hridaykrishna2007-a11y/rp-Board/Images/PCB F&B.png

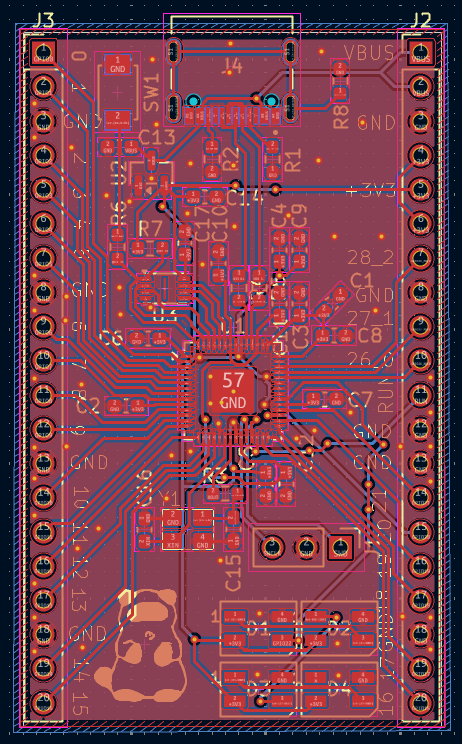
Images/PCB F&B.png
