hridaykrishna2007-a11y/rp-Board/BOM/BOM.csv

Index | LCSC# | MPN | Manufacturer | Package | Customer # | Description | RoHS | Quantity | MOQ | Multiple | Unit Price($) | Extended Price($) | Product Link
1 | C2040 | RP2040 | Raspberry Pi | LQFN-56(7x7) |  | ARM Cortex-M0+ 32 Bit 133MHz LQFN-56(7x7) Microcontrollers | yes | 4 | 1 | 1 | 0.9975 | 3.99 | https://www.lcsc.com/product-detail/C2040.html
2 | C29936 | CL10B105KA8NNNC | Samsung Electro-Mechanics | 0603 |  | 1uF ±10% 25V Ceramic Capacitor X7R 0603 | yes | 100 | 10 | 10 | 0.0179 | 1.79 | https://www.lcsc.com/product-detail/C29936.html
3 | C1591 | CL10B104KB8NNNC | Samsung Electro-Mechanics | 0603 |  | 100nF ±10% 50V Ceramic Capacitor X7R 0603 | yes | 100 | 100 | 100 | 0.0084 | 0.84 | https://www.lcsc.com/product-detail/C1591.html
4 | C1691 | CL10A106MQ8NNNC | Samsung Electro-Mechanics | 0603 |  | 10uF ±20% 6.3V Ceramic Capacitor X5R 0603 | yes | 100 | 10 | 10 | 0.0145 | 1.45 | https://www.lcsc.com/product-detail/C1691.html
5 | C2907044 | FRC0603F5101TS | FOJAN | 0603 |  | 5.1kΩ ±1% 100mW 0603 Thick Film Resistor | yes | 100 | 100 | 100 | 0.0019 | 0.19 | https://www.lcsc.com/product-detail/C2907044.html
6 | C2907002 | FRC0603F1001TS | FOJAN | 0603 |  | 1kΩ ±1% 100mW 0603 Thick Film Resistor | yes | 100 | 100 | 100 | 0.0021 | 0.21 | https://www.lcsc.com/product-detail/C2907002.html
7 | C2907136 | FRC0603J270 TS | FOJAN | 0603 |  | 27Ω ±5% 100mW 0603 Thick Film Resistor | yes | 100 | 100 | 100 | 0.0022 | 0.22 | https://www.lcsc.com/product-detail/C2907136.html
8 | C95204 | RT0603BRD0710KL | YAGEO | 0603 |  | 100mW 10kΩ 75V Thin Film Resistor ±25ppm/℃ ±0.1% 0603 Chip Resistor - Surface Mount RoHS | yes | 40 | 20 | 20 | 0.0331 | 1.32 | https://www.lcsc.com/product-detail/C95204.html
9 | C1663 | CL10C330JB8NNNC | Samsung Electro-Mechanics | 0603 |  | 33pF ±5% 50V Ceramic Capacitor C0G 0603 | yes | 100 | 50 | 50 | 0.0089 | 0.89 | https://www.lcsc.com/product-detail/C1663.html
10 | C39051 | MCP1700T-3302E/TT | MICROCHIP | SOT-23 |  | 3.3V Positive Fixed SOT-23 Voltage Regulators - Linear, Low Drop Out (LDO) Regulators RoHS | yes | 5 | 1 | 1 | 0.3999 | 2.00 | https://www.lcsc.com/product-detail/C39051.html
11 | C9002 | X322512MSB4SI | YXC Crystal Oscillators | SMD3225-4P |  | Crystal 12MHz ±10ppm 20pF SMD3225-4P | yes | 5 | 5 | 5 | 0.0960 | 0.48 | https://www.lcsc.com/product-detail/C9002.html
12 | C2765186 | TYPE-C 16PIN 2MD(073) | SHOU HAN | SMD |  | USB-C (USB TYPE-C) Receptacle Connector 16 Position Surface Mount, Right Angle | yes | 20 | 20 | 20 | 0.0716 | 1.43 | https://www.lcsc.com/product-detail/C2765186.html
13 | C720477 | TS-1088-AR02016 | XUNPU | SMD,4x3mm |  | Tactile Switch SPST 160gf 2mm SMD (SMT) Tab 4mm x 3mm Surface Mount | yes | 10 | 10 | 10 | 0.0504 | 0.50 | https://www.lcsc.com/product-detail/C720477.html
14 | C2456208 | W25Q16JVZPIQ | Winbond | WSON-8-EP(5x6) |  | 16Mbit 2.7V~3.6V 133MHz SPI WSON-8-EP(5x6) Memory RoHS | yes | 4 | 1 | 1 | 1.9161 | 7.66 | https://www.lcsc.com/product-detail/C2456208.html
15 | C114586 | WS2812B-B/W | Worldsemi | SMD5050-4P |  | SMD5050-4P LED Addressable, Specialty | yes | 10 | 5 | 5 | 0.1042 | 1.04 | https://www.lcsc.com/product-detail/C114586.html
