hridaykrishna2007-a11y/rp-Board/PCB/rp2040 led.kicad_pcb

## KiCad design PCB/rp2040 led.kicad_pcb (2026-10-29)

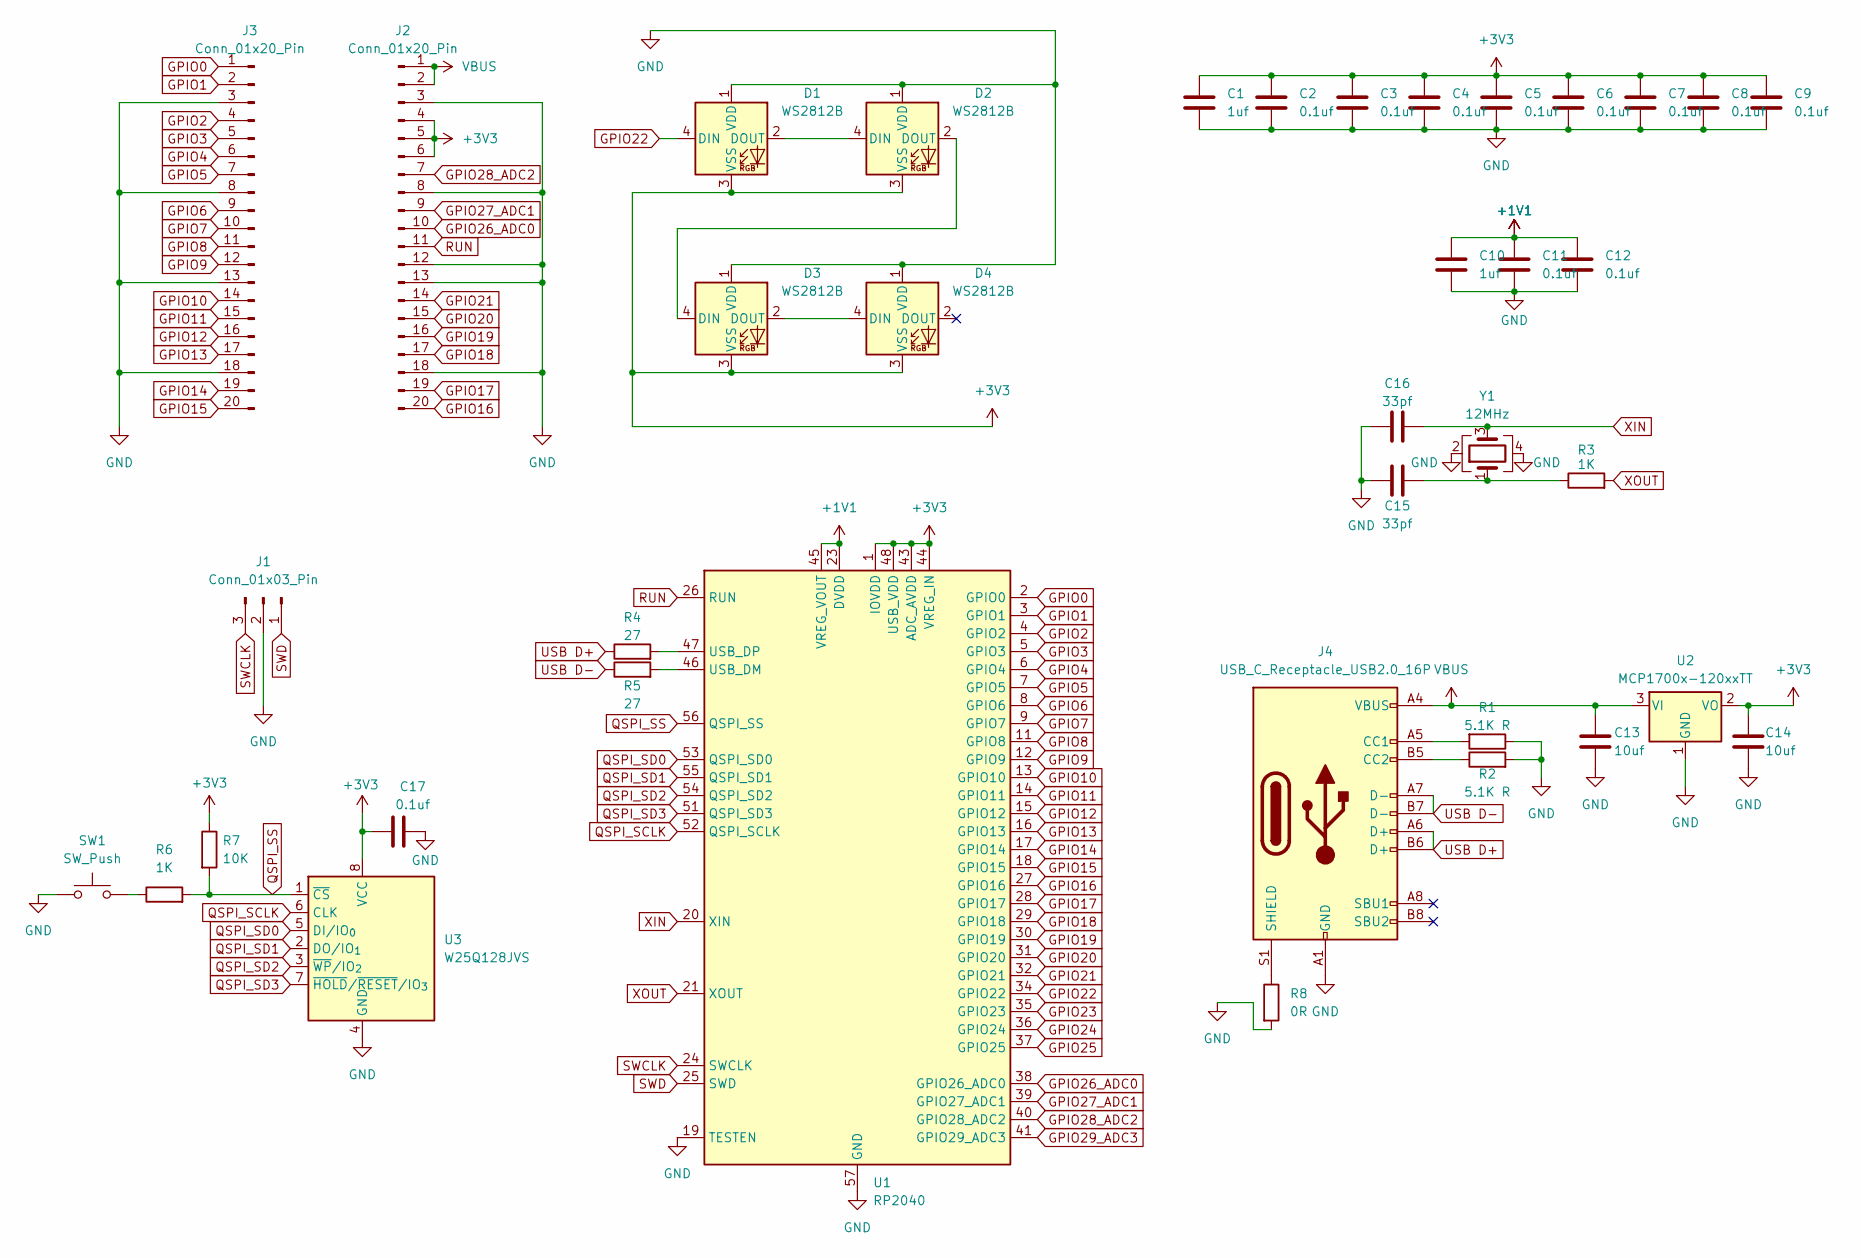
[picture p8: schematic rp2040 led.kicad_sch]

Parts:
C1, C10: 1uf; C_0603_1608Metric_Pad1.08x0.95mm_HandSolder
C2, C3, C4, C5, C6, C7, C8, C9, C11, C12, C17: 0.1uf; C_0603_1608Metric_Pad1.08x0.95mm_HandSolder
C13, C14: 10uf; C_0603_1608Metric_Pad1.08x0.95mm_HandSolder
C15, C16: 33pf; C_0603_1608Metric_Pad1.08x0.95mm_HandSolder
D1, D2, D3, D4: WS2812B; LED_WS2812B_PLCC4_5.0x5.0mm_P3.2mm
J1: Conn_01x03_Pin; PinHeader_1x03_P2.54mm_Vertical
J2, J3: Conn_01x20_Pin; PinHeader_1x20_P2.54mm_Vertical
J4: USB_C_Receptacle_USB2.0_16P; SHOUHAN_TYPE-C_16PIN_2MD__073_
R1, R2: 5.1K R; R_0603_1608Metric_Pad0.98x0.95mm_HandSolder
R3, R6: 1K; R_0603_1608Metric_Pad0.98x0.95mm_HandSolder
R4, R5: 27; R_0603_1608Metric_Pad0.98x0.95mm_HandSolder
R7: 10K; R_0603_1608Metric_Pad0.98x0.95mm_HandSolder
R8: 0R; R_0603_1608Metric_Pad0.98x0.95mm_HandSolder
SW1: SW_Push; SW_TS-1088-AR02016
U1: RP2040; QFN-56-1EP_7x7mm_P0.4mm_EP3.2x3.2mm
U2: MCP1700x-120xxTT; SOT-23
U3: W25Q128JVS; Winbond_USON-8-1EP_3x2mm_P0.5mm_EP0.2x1.6mm
Y1: 12MHz; Crystal_X322512MSB4SI

Connections:
+1V1: C10.1, C11.1, C12.1, U1.23 (DVDD), U1.45 (VREG_VOUT), U1.50 (DVDD)
+3V3: C1.2, C2.1, C3.1, C4.1, C5.1, C6.1, C7.1, C8.1, C9.1, C14.1, C17.1, D1.3 (VSS), D2.3 (VSS), D3.3 (VSS), D4.3 (VSS), J2.4, J2.5, J2.6, R7.1, U1.1 (IOVDD), U1.10 (IOVDD), U1.22 (IOVDD), U1.33 (IOVDD), U1.42 (IOVDD), U1.43 (ADC_AVDD), U1.44 (VREG_IN), U1.48 (USB_VDD), U1.49 (IOVDD), U2.2 (VO), U3.8 (VCC)
GND: C1.1, C2.2, C3.2, C4.2, C5.2, C6.2, C7.2, C8.2, C9.2, C10.2, C11.2, C12.2, C13.2, C14.2, C15.1, C16.1, C17.2, D1.1 (VDD), D2.1 (VDD), D3.1 (VDD), D4.1 (VDD), J1.2, J2.3, J2.8, J2.12, J2.13, J2.18, J3.3, J3.8, J3.13, J3.18, J4.A1 (GND), J4.A12 (GND), J4.B1 (GND), J4.B12 (GND), R1.1, R2.2, R8.2, SW1.1, U1.19 (TESTEN), U1.57 (GND), U2.1 (GND), U3.4 (GND), Y1.2, Y1.4
GPIO0: J3.1, U1.2 (GPIO0)
GPIO1: J3.2, U1.3 (GPIO1)
GPIO2: J3.4, U1.4 (GPIO2)
GPIO3: J3.5, U1.5 (GPIO3)
GPIO4: J3.6, U1.6 (GPIO4)
GPIO5: J3.7, U1.7 (GPIO5)
GPIO6: J3.9, U1.8 (GPIO6)
GPIO7: J3.10, U1.9 (GPIO7)
GPIO8: J3.11, U1.11 (GPIO8)
GPIO9: J3.12, U1.12 (GPIO9)
GPIO10: J3.14, U1.13 (GPIO10)
GPIO11: J3.15, U1.14 (GPIO11)
GPIO12: J3.16, U1.15 (GPIO12)
GPIO13: J3.17, U1.16 (GPIO13)
GPIO14: J3.19, U1.17 (GPIO14)
GPIO15: J3.20, U1.18 (GPIO15)
GPIO16: J2.20, U1.27 (GPIO16)
GPIO17: J2.19, U1.28 (GPIO17)
GPIO18: J2.17, U1.29 (GPIO18)
GPIO19: J2.16, U1.30 (GPIO19)
GPIO20: J2.15, U1.31 (GPIO20)
GPIO21: J2.14, U1.32 (GPIO21)
GPIO22: D1.4 (DIN), U1.34 (GPIO22)
GPIO23: U1.35 (GPIO23)
GPIO24: U1.36 (GPIO24)
GPIO25: U1.37 (GPIO25)
GPIO26_ADC0: J2.10, U1.38 (GPIO26_ADC0)
GPIO27_ADC1: J2.9, U1.39 (GPIO27_ADC1)
GPIO28_ADC2: J2.7, U1.40 (GPIO28_ADC2)
GPIO29_ADC3: U1.41 (GPIO29_ADC3)
unnamed: C15.2, R3.1, Y1.1
unnamed: D1.2 (DOUT), D2.4 (DIN)
unnamed: D2.2 (DOUT), D3.4 (DIN)
unnamed: D3.2 (DOUT), D4.4 (DIN)
unnamed: J4.A5 (CC1), R1.2
unnamed: J4.B5 (CC2), R2.1
unnamed: J4.S1 (SHIELD), R8.1
unnamed: R6.1, SW1.2
unnamed: R5.2, U1.46 (USB_DM)
unnamed: R4.2, U1.47 (USB_DP)
QSPI_SCLK: U1.52 (QSPI_SCLK), U3.6 (CLK)
QSPI_SD0: U1.53 (QSPI_SD0), U3.5 (DI/IO_{0})
QSPI_SD1: U1.55 (QSPI_SD1), U3.2 (DO/IO_{1})
QSPI_SD2: U1.54 (QSPI_SD2), U3.3 (~WP/IO_{2})
QSPI_SD3: U1.51 (QSPI_SD3), U3.7 (~HOLD/~RESET/IO_{3})
QSPI_SS: R6.2, R7.2, U1.56 (QSPI_SS), U3.1 (~CS)
RUN: J2.11, U1.26 (RUN)
SWCLK: J1.3, U1.24 (SWCLK)
SWD: J1.1, U1.25 (SWD)
USB D+: J4.A6 (D+), J4.B6 (D+), R4.1
USB D-: J4.A7 (D-), J4.B7 (D-), R5.1
VBUS: C13.1, J2.1, J2.2, J4.A4 (VBUS), J4.A9 (VBUS), J4.B4 (VBUS), J4.B9 (VBUS), U2.3 (VI)
XIN: C16.2, U1.20 (XIN), Y1.3
XOUT: R3.2, U1.21 (XOUT)

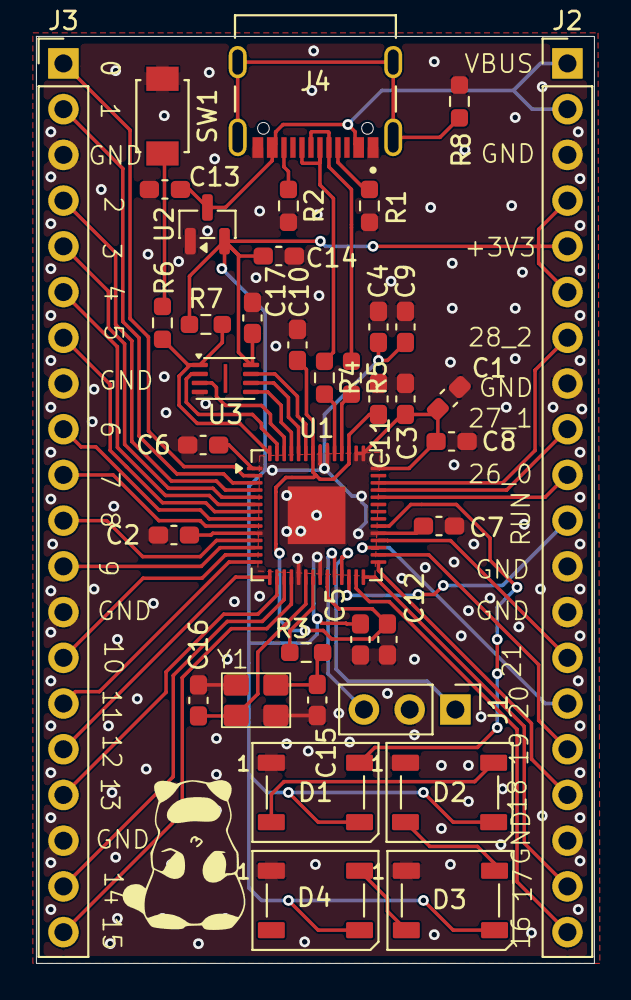
[picture p9: board rp2040 led.kicad_pcb from above]

Board: 2 copper layers, 31.0 x 51.5 mm, 38 parts (0 on the bottom side), 53 nets.
