hridaykrishna2007-a11y/rp-Board/JOURNAL.md

# rpBoard — Journal Export

- Exported at: 2026-10-05T13:09:53Z
- Project ID: 4138
- Entries: 13

## Entry 1
- ID: 11706
- Author: Hriday Krishna
- Created At: 2026-06-04T20:55:26Z

### Content

processor used: rp2040
i referred the datasheets
looked at pi pico schematics etc for inspo 
im also using the tutorials online and on hack club but on a diff device. im not afk-ing 
building the schematic
schematic made or rp2040, decoupling caps, vreg,crystal, gpios, usb etc
IM ALSO PLANNING TO PUT A 3X3 MATRIX !processor used: rp2040
i referred the datasheets
looked at pi pico schematics etc for inspo 
im also using the tutorials online and on hack club but on a diff device. im not afk-ing 
building the schematic
schematic made or rp2040, decoupling caps, vreg,crystal, gpios, usb etc
IM ALSO PLANNING TO PUT A 3X3 MATRIX !


### Recording Links

- https://public.lapse-hackclub.link/timelapses/bwekNHADBVEO/timelapse-bwekNHADBVEO.mp4
- https://public.lapse-hackclub.link/timelapses/A4BpYBr-brFP/timelapse-A4BpYBr-brFP.mp4
- https://public.lapse-hackclub.link/timelapses/6pvnv-r1G7lA/timelapse-6pvnv-r1G7lA.mp4
- https://public.lapse-hackclub.link/timelapses/42IP-2GGhpd6/timelapse-42IP-2GGhpd6.mp4
- https://public.lapse-hackclub.link/timelapses/O4s7wMNSTT04/timelapse-O4s7wMNSTT04.mp4
- https://public.lapse-hackclub.link/timelapses/1b5yeCcgr6H-/timelapse-1b5yeCcgr6H-.mp4

## Entry 2
- ID: 12968
- Author: Hriday Krishna
- Created At: 2026-06-10T08:36:39Z

### Content

lookout test
Lapse is down T-T
i have around 2 hours of journals which aint logged yet 

............


### Recording Links

- https://lookout.hackclub.com/api/media/ae3add24-0397-4caf-b297-6a29eb78b464/video.mp4

## Entry 3
- ID: 13021
- Author: Hriday Krishna
- Created At: 2026-06-10T15:12:53Z

### Content

I searched for parts and made the bom file for the devbord. 
next, im gonna collect the footprints and make the pcb
Screenshot 2026-06-10 204118.png

### Recording Links

- https://lookout.hackclub.com/api/media/87f9366f-f554-408e-ad85-cdb326351c8c/video.mp4
- https://lookout.hackclub.com/api/media/924b160b-b47d-4270-823b-c0d34c61ee89/video.mp4

## Entry 4
- ID: 13051
- Author: Hriday Krishna
- Created At: 2026-06-10T16:53:33Z

### Content

i forgot abt the main thing in this devboard lmaoo
i am also adding a 2x2 sk6812mini-e leds
i learnt how it works, faced some confusions 
but wired it up finally.
i also made some resarch about the diff types of usb2.0 receptacle. [14pin, 16 pin, etc]



another thing
lapse aint working now T-T
i dont have 1.5-3 hrs logged yet

### Recording Links

- https://lookout.hackclub.com/api/media/8c6174ba-0bd1-4608-88da-dd1f46159c17/video.mp4

## Entry 5
- ID: 13219
- Author: Hriday Krishna
- Created At: 2026-06-11T12:55:36Z

### Content

i searched for a crystal to add on the board
decided on X322512MSB4SI but i couldnt find the footprint anywhere T-T

started watching a yt vid of making a custom footprint


also did some research abt the crystal 

### Recording Links

- https://lookout.hackclub.com/api/media/f26db6c0-99c0-4e02-b2ab-21be511aa3c8/video.mp4
- https://lookout.hackclub.com/api/media/4a1cdaa8-6b73-46d5-aa59-9809a3be4e25/video.mp4
- https://lookout.hackclub.com/api/media/b3c1740d-692b-43bf-8141-21a87936f22d/video.mp4

## Entry 6
- ID: 13648
- Author: Hriday Krishna
- Created At: 2026-06-13T05:34:43Z

### Content

learnt about making footprints and made one XD
it was a little confusing at first. 
but finally managed with a yt tutorial lol



### Recording Links

- https://lookout.hackclub.com/api/media/71026d86-6ba7-45bc-a275-6937a3629058/video.mp4

## Entry 7
- ID: 13945
- Author: Hriday Krishna
- Created At: 2026-06-14T10:35:46Z

### Content

learnt abt importing footprints for th components that dont have a footprint on kicad
searched for a BOOTSEL switch in LCSC and found it
assigned all the footprints, 
rechecked the schematics for any possible error
done!
Gotta route now loll


### Recording Links

- https://lookout.hackclub.com/api/media/034217a1-451b-4b5a-a25d-e9f2fd47bc41/video.mp4

## Entry 8
- ID: 13972
- Author: Hriday Krishna
- Created At: 2026-06-14T13:42:43Z

### Content

Partially routed the board.
placing the components so that the traces don't intersect, was a little too confusing.
placing the required amount of decoupling capacitors for the pins of the board was confusing. so it took some time...



### Recording Links

- https://lookout.hackclub.com/api/media/2f9b1db7-05ce-4e8b-9f14-aaddae397f19/video.mp4
- https://lookout.hackclub.com/api/media/edc749f3-8a97-4007-b3df-ef7de23c49cd/video.mp4
- https://lookout.hackclub.com/api/media/0c631ba4-cb29-4c1c-84a9-34dc38ceffdf/video.mp4

## Entry 9
- ID: 14276
- Author: Hriday Krishna
- Created At: 2026-06-15T17:11:08Z

### Content

STILL ROUTING T-T
Placement of capacitors so that it can still be routed properly is fryin me
trial and error loll



### Recording Links

- https://lookout.hackclub.com/api/media/75ece09a-e5f2-4489-b1f9-610ff3c638f7/video.mp4
- https://lookout.hackclub.com/api/media/fe5d51b7-c3e3-4831-bc20-0bdfed3109a7/video.mp4
- https://lookout.hackclub.com/api/media/059e64c3-225c-48db-bbdb-b7105d78529d/video.mp4
- https://lookout.hackclub.com/api/media/2a37cc87-b949-4fc3-83cf-9e74f8c3f3d2/video.mp4

## Entry 10
- ID: 14506
- Author: Hriday Krishna
- Created At: 2026-06-16T12:24:02Z

### Content

Still routing lol.
the vbus pins from usb were not at all connecting to any other pins...
had to learn abt usb's, etc and edit the footprint


still a little more routing is pending.

### Recording Links

- https://lookout.hackclub.com/api/media/545d737d-19ed-41db-8721-e7f43fe700db/video.mp4
- https://lookout.hackclub.com/api/media/4a79be85-7033-4760-b25c-e4db56546011/video.mp4
- https://lookout.hackclub.com/api/media/86b0c313-4e82-4254-918a-258ffa388c00/video.mp4

## Entry 11
- ID: 14600
- Author: Hriday Krishna
- Created At: 2026-06-16T18:44:46Z

### Content

I did routing here again. 
i wanted multiple pins to act as vbus and +3v3 pins
experimented with different gnd plane settings to find the perfect one for my board
another thing. i didnt know wether i should ground the shield of my usb receptacle. so i just isolated it.
if it needs to be grounded, ill just add some loose solder connecting the two pads, or imma just leave it alone
i kinda rediscovered jumpers and 0 ohm resistors lmaoooo




### Recording Links

- https://lookout.hackclub.com/api/media/e5a0daa1-4d92-429f-9469-c903dce8331e/video.mp4
- https://lookout.hackclub.com/api/media/9849d9dc-755d-4787-ae25-408f747122c9/video.mp4

## Entry 12
- ID: 14743
- Author: Hriday Krishna
- Created At: 2026-06-17T13:03:37Z

### Content

Saw a vid on youtube to add a pic of soup hehe.
Also added a pic of my fav movie character, Spider Man.
got some doubts regarding IOVDD and DVDD pins, so i checked other rp2040 guides on hack club and other rp2040 based boards
i also spent the remaining the time logged here debugging the circuit with DRC and put vias in the gnd planes that needed one.





### Recording Links

- https://lookout.hackclub.com/api/media/bf5e99a7-90e8-477a-ae06-a054641199d5/video.mp4
- https://lookout.hackclub.com/api/media/31b11588-8baf-4c39-b6b4-8b5dd79dea24/video.mp4
- https://lookout.hackclub.com/api/media/dc094d4d-fbfe-4c25-ab91-b1b52d49457a/video.mp4
- https://lookout.hackclub.com/api/media/3067f787-1189-4f72-939e-05202475d8f5/video.mp4

## Entry 13
- ID: 15034
- Author: Hriday Krishna
- Created At: 2026-06-18T17:49:41Z

### Content

i changed the spidey pic.
i rechecked the pcb again. the was an isolated ground plane lmaooo
Rechecked again
made a proper bom with the help of lcsc[i may get them delivered to me at shenzen itself]

learnt how to make gerbers, assigned 3d models of the objects to its footprints.
added em, and took a few ss

Screenshot 2026-06-18 231044.png


### Recording Links

- https://lookout.hackclub.com/api/media/314a7ce3-30f8-4e57-9924-a41aa44557e2/video.mp4
- https://lookout.hackclub.com/api/media/dfb5c5c2-4c80-4597-9292-1c4b16c1bd7b/video.mp4
