hridaykrishna2007-a11y/rp-Board/(commit log)

2026-07-05 Update README.md
    Added information about SK6812MINI-E LEDs on the PCB.
2026-07-05 Add files via upload
    Files!
    [BOM(1).csv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]
2026-10-15 new BOM
2026-10-15 bom updated
